kanpapa/VMEbus-AXPvme/README.md

# VMEbus-AXPvme
This repository contains documentation and sources for running DEC AXPvme 230
