kanpapa/VMEbus-AXPvme/KiCad/VME_axpvme230_p2/VME_axpvme230_p2_1.jpg

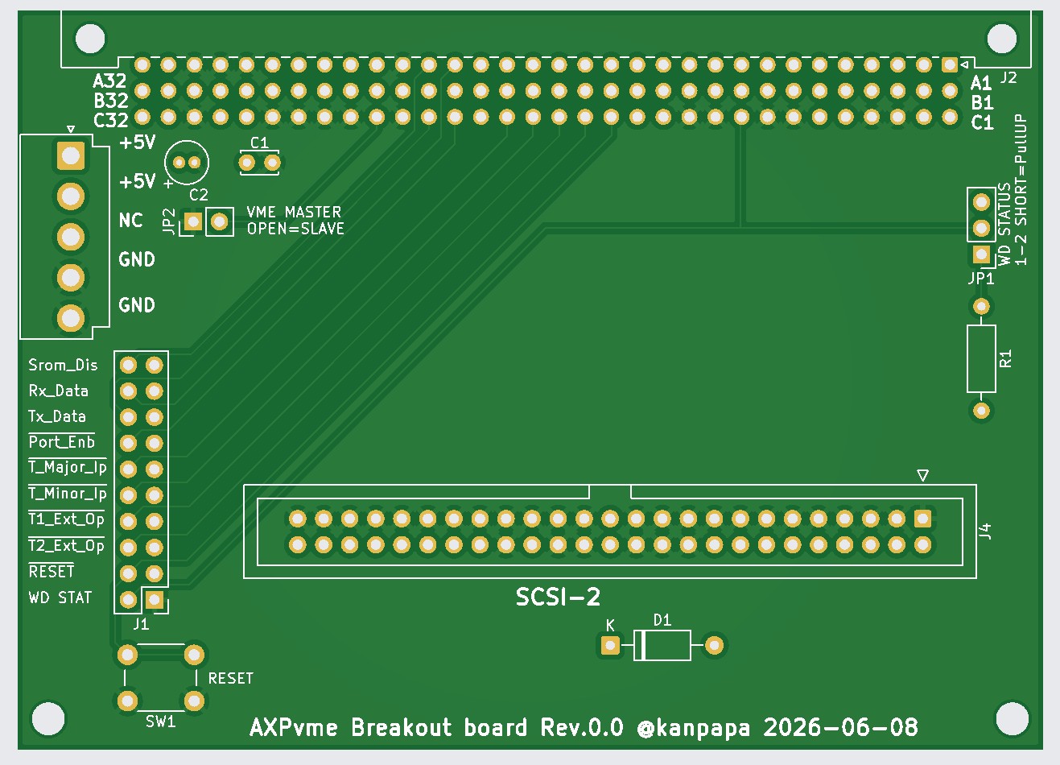
KiCad/VME_axpvme230_p2/VME_axpvme230_p2_1.jpg
