kanpapa/VMEbus-AXPvme/KiCad/VME_axpvme230_p2_dual/VME_axpvme230_p2_dual_sch.pdf

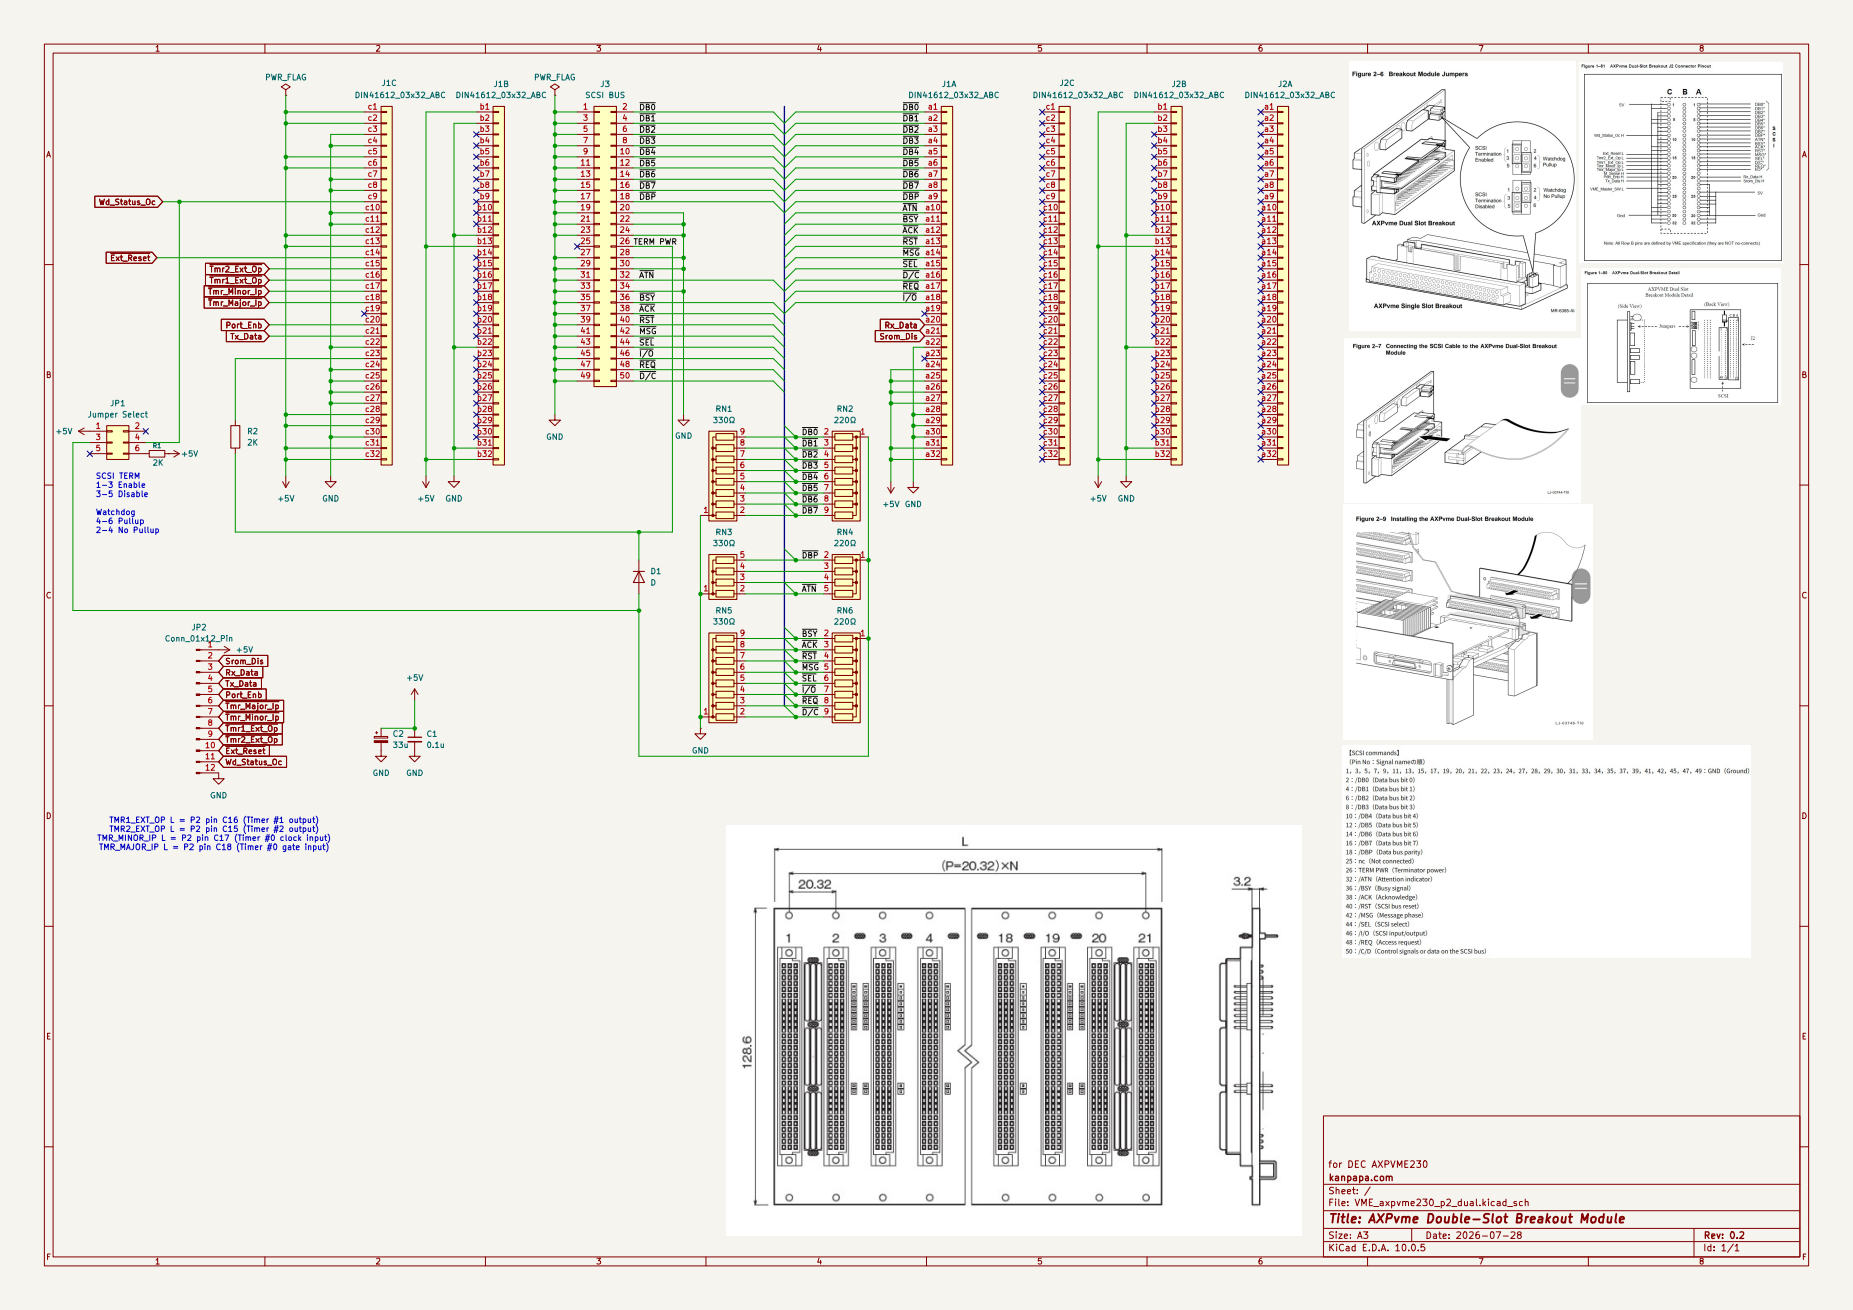
[picture p6: page 1]
