kanpapa/VMEbus-AXPvme/KiCad/VME_axpvme230_p2/VME_axpvme230_p2_sch.pdf

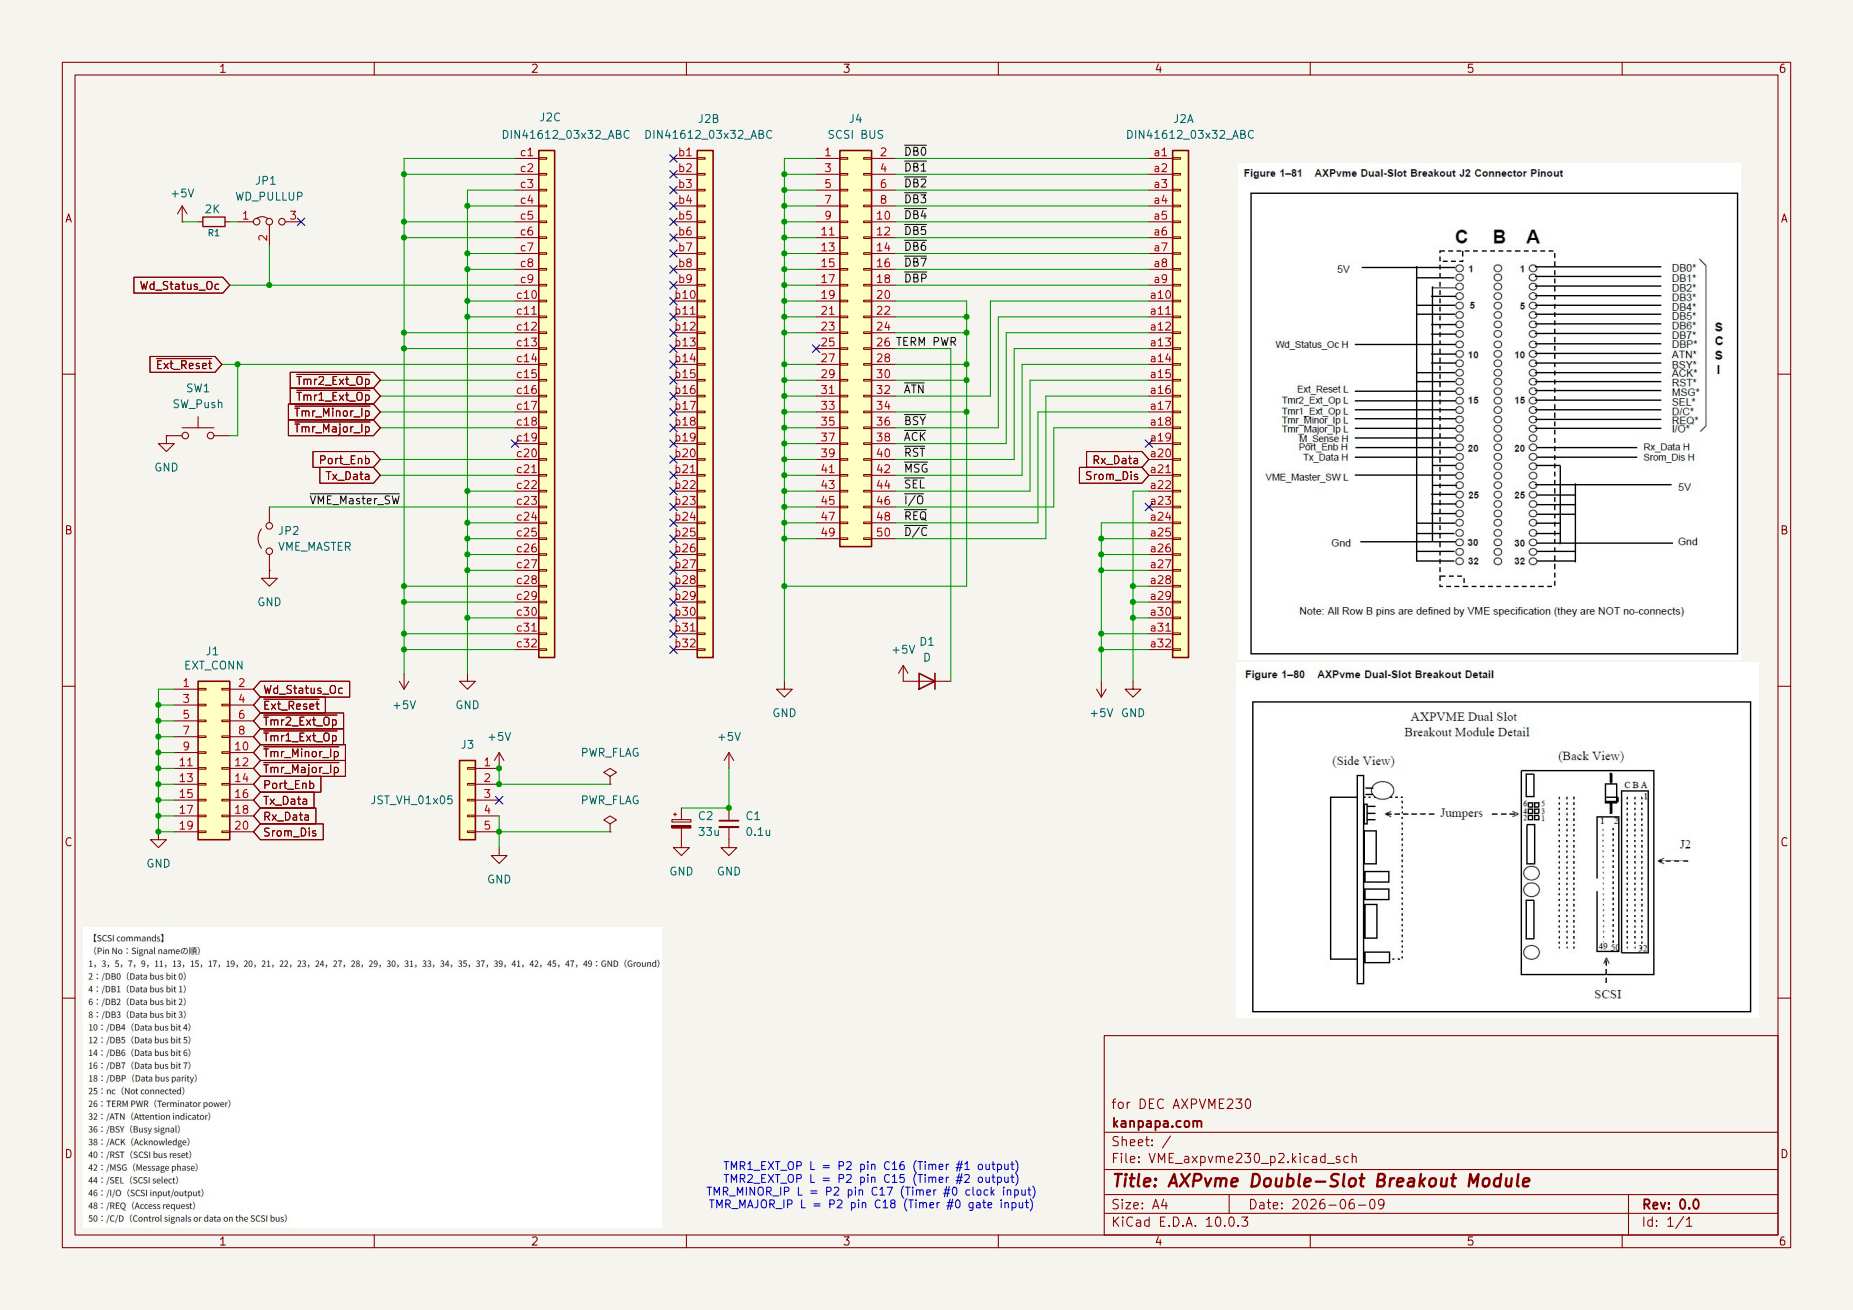
[picture p7: page 1]
