kanpapa/VMEbus-AXPvme/KiCad/VME_axpvme230_p2_dual/VME_axpvme230_p2_dual.kicad_pcb

## KiCad design KiCad/VME_axpvme230_p2_dual/VME_axpvme230_p2_dual.kicad_pcb (2026-07-12)

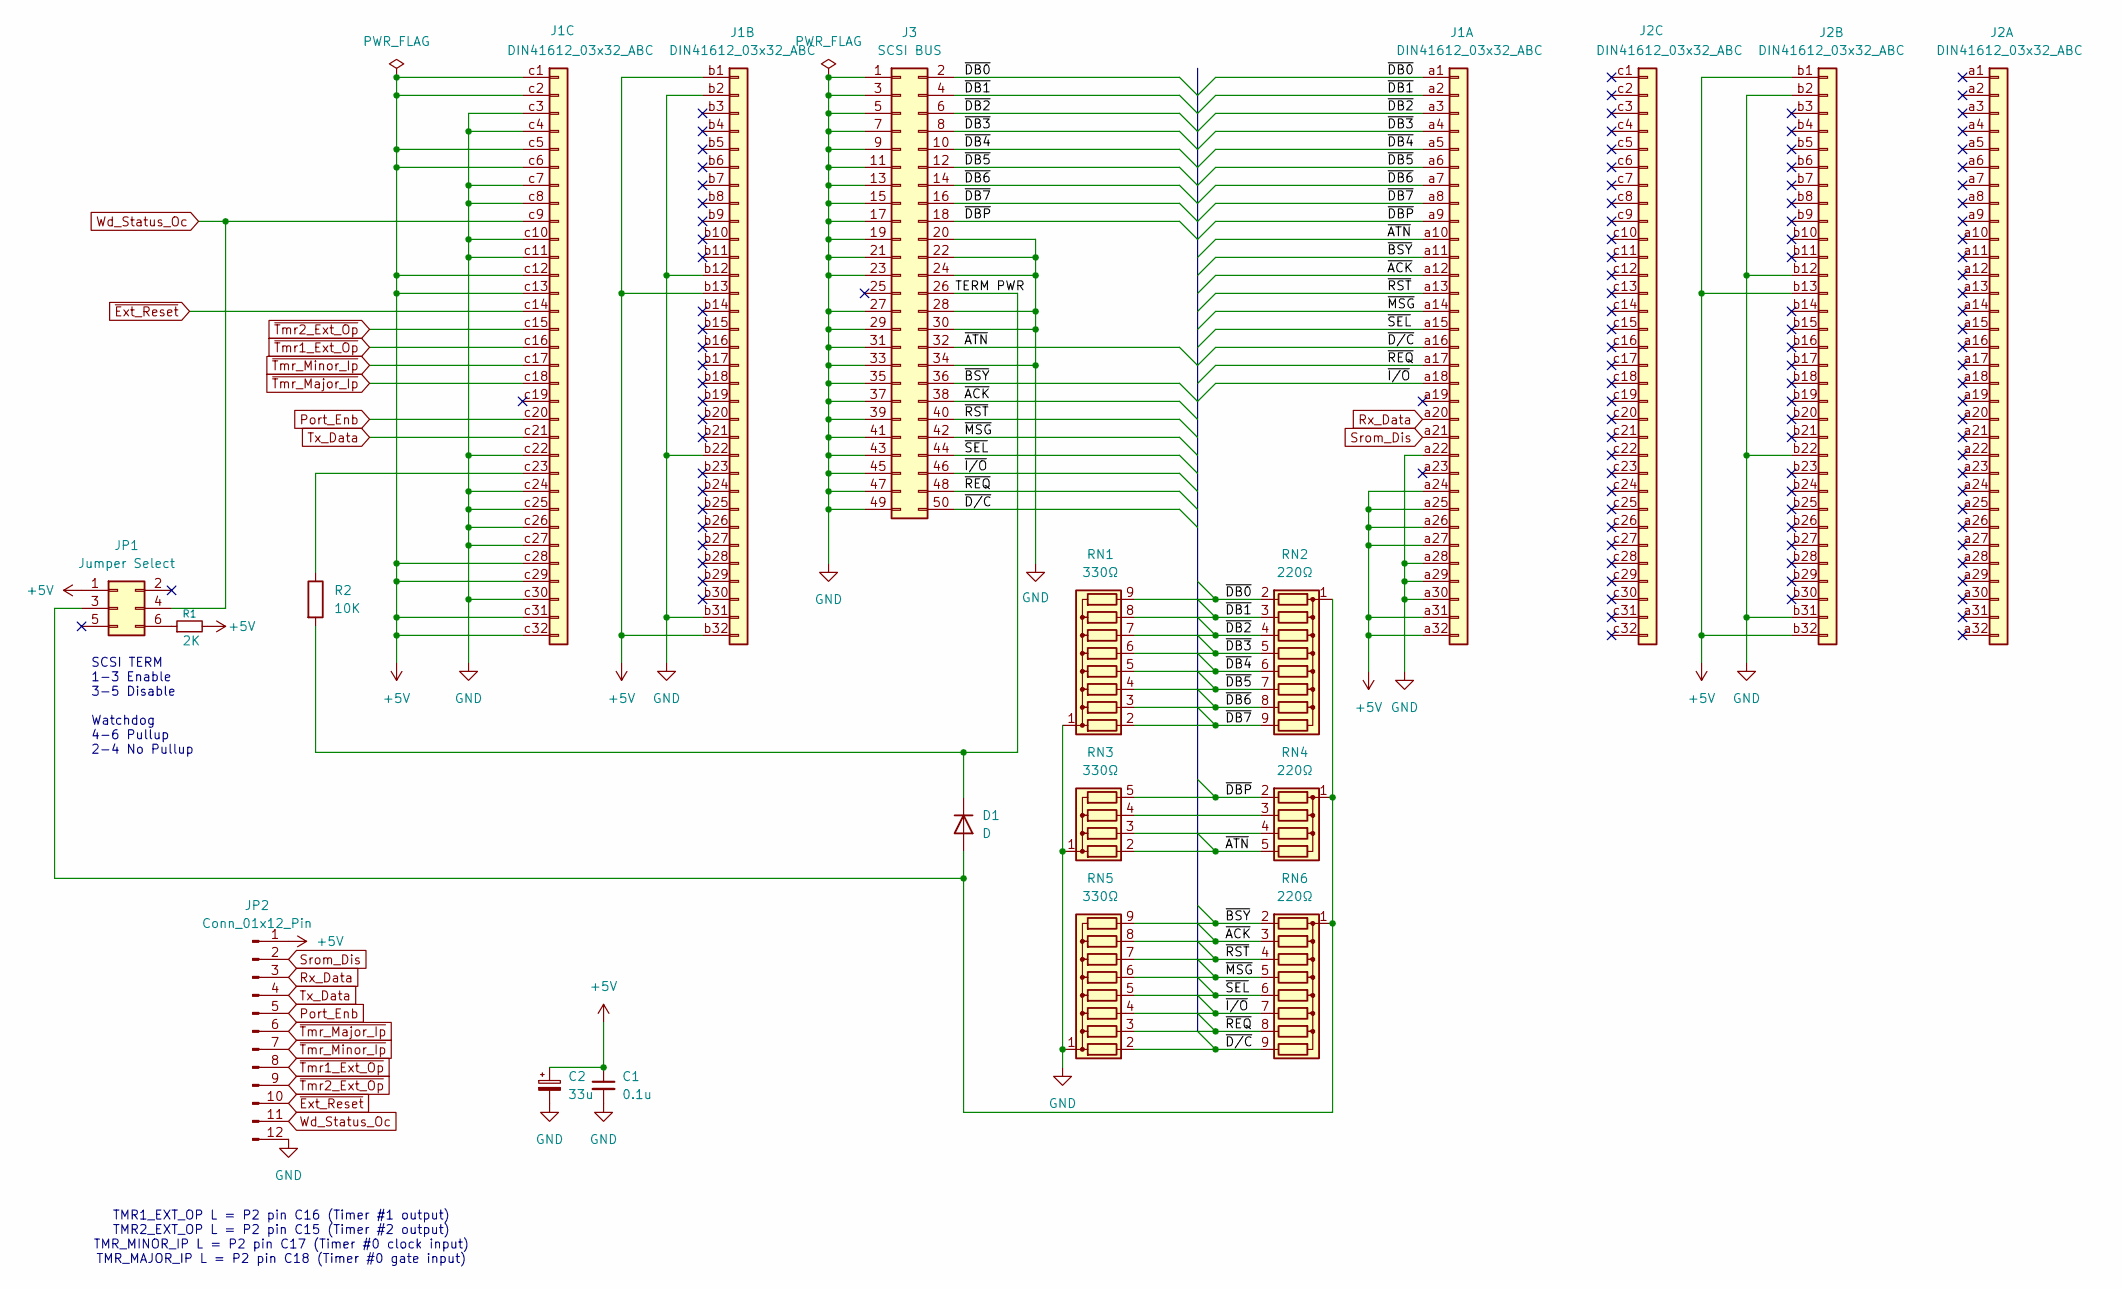
[picture p8: schematic VME_axpvme230_p2_dual.kicad_sch, AXPvme Double-Slot Breakout Module]

Parts:
C1: 0.1u; C_Disc_D3.4mm_W2.1mm_P2.50mm
C2: 33u; C_Radial_D4.0mm_H5.0mm_P1.50mm
D1: D; D_A-405_P7.62mm_Horizontal
J1, J2: DIN41612_03x32_ABC; DIN41612_C_3x32_Female_Vertical_THT
J3: SCSI BUS; IDC-Header_2x25_P2.54mm_Vertical
JP1: Jumper Select; PinHeader_2x03_P2.54mm_Vertical
JP2: Conn_01x12_Pin; PinHeader_1x12_P2.54mm_Vertical
R1: 2K; R_Axial_DIN0207_L6.3mm_D2.5mm_P7.62mm_Horizontal
R2: 10K; R_Axial_DIN0207_L6.3mm_D2.5mm_P7.62mm_Horizontal
RN1, RN5: 330Ω; R_Array_SIP9
RN2, RN6: 220Ω; R_Array_SIP9
RN3: 330Ω; R_Array_SIP5
RN4: 220Ω; R_Array_SIP5

Connections:
+5V: C1.1, C2.1, J1.a24, J1.a25, J1.a26, J1.a27, J1.a31, J1.a32, J1.b1, J1.b13, J1.b32, J1.c1, J1.c2, J1.c5, J1.c6, J1.c12, J1.c13, J1.c28, J1.c29, J1.c31, J1.c32, J2.b1, J2.b13, J2.b32, JP1.1, JP2.1, R1.2
/TERM PWR: D1.1 (K), J3.26, R2.2
/~ACK: J1.a12, J3.38, RN5.8 (R7), RN6.3 (R2)
/~ATN: J1.a10, J3.32, RN3.2 (R1), RN4.5 (R4)
/~BSY: J1.a11, J3.36, RN5.9 (R8), RN6.2 (R1)
/~DB0: J1.a1, J3.2, RN1.9 (R8), RN2.2 (R1)
/~DB1: J1.a2, J3.4, RN1.8 (R7), RN2.3 (R2)
/~DB2: J1.a3, J3.6, RN1.7 (R6), RN2.4 (R3)
/~DB3: J1.a4, J3.8, RN1.6 (R5), RN2.5 (R4)
/~DB4: J1.a5, J3.10, RN1.5 (R4), RN2.6 (R5)
/~DB5: J1.a6, J3.12, RN1.4 (R3), RN2.7 (R6)
/~DB6: J1.a7, J3.14, RN1.3 (R2), RN2.8 (R7)
/~DB7: J1.a8, J3.16, RN1.2 (R1), RN2.9 (R8)
/~DBP: J1.a9, J3.18, RN3.5 (R4), RN4.2 (R1)
/~D/C: J1.a16, J3.50, RN5.2 (R1), RN6.9 (R8)
/~I/O: J1.a18, J3.46, RN5.4 (R3), RN6.7 (R6)
/~MSG: J1.a14, J3.42, RN5.6 (R5), RN6.5 (R4)
/~REQ: J1.a17, J3.48, RN5.3 (R2), RN6.8 (R7)
/~RST: J1.a13, J3.40, RN5.7 (R6), RN6.4 (R3)
/~SEL: J1.a15, J3.44, RN5.5 (R4), RN6.6 (R5)
GND: C1.2, C2.2, J1.a22, J1.a28, J1.a29, J1.a30, J1.b2, J1.b12, J1.b22, J1.b31, J1.c3, J1.c4, J1.c7, J1.c8, J1.c10, J1.c11, J1.c22, J1.c24, J1.c25, J1.c26, J1.c27, J1.c30, J2.b2, J2.b12, J2.b22, J2.b31, J3.1, J3.3, J3.5, J3.7, J3.9, J3.11, J3.13, J3.15, J3.17, J3.19, J3.20, J3.21, J3.22, J3.23, J3.24, J3.27, J3.28, J3.29, J3.30, J3.31, J3.33, J3.34, J3.35, J3.37, J3.39, J3.41, J3.43, J3.45, J3.47, J3.49, JP2.12, RN1.1 (common), RN3.1 (common), RN5.1 (common)
unnamed: D1.2 (A), JP1.3, RN2.1 (common), RN4.1 (common), RN6.1 (common)
unnamed: J1.c23, R2.1
unnamed: JP1.6, R1.1
unnamed: RN3.3 (R2), RN4.4 (R3)
unnamed: RN3.4 (R3), RN4.3 (R2)
Port_Enb: J1.c20, JP2.5
Rx_Data: J1.a20, JP2.3
Srom_Dis: J1.a21, JP2.2
Tx_Data: J1.c21, JP2.4
Wd_Status_Oc: J1.c9, JP1.4, JP2.11
~Ext_Reset: J1.c14, JP2.10
~Tmr1_Ext_Op: J1.c16, JP2.8
~Tmr2_Ext_Op: J1.c15, JP2.9
~Tmr_Major_Ip: J1.c18, JP2.6
~Tmr_Minor_Ip: J1.c17, JP2.7

Notes on the sheet:
TMR1_EXT_OP L = P2 pin C16 (Timer #1 output) TMR2_EXT_OP L = P2 pin C15 (Timer #2 output) TMR_MINOR_IP L = P2 pin C17 (Timer #0 clock input) TMR_MAJOR_IP L = P2 pin C18 (Timer #0 gate input)
SCSI TERM 1-3 Enable 3-5 Disable Watchdog 4-6 Pullup 2-4 No Pullup

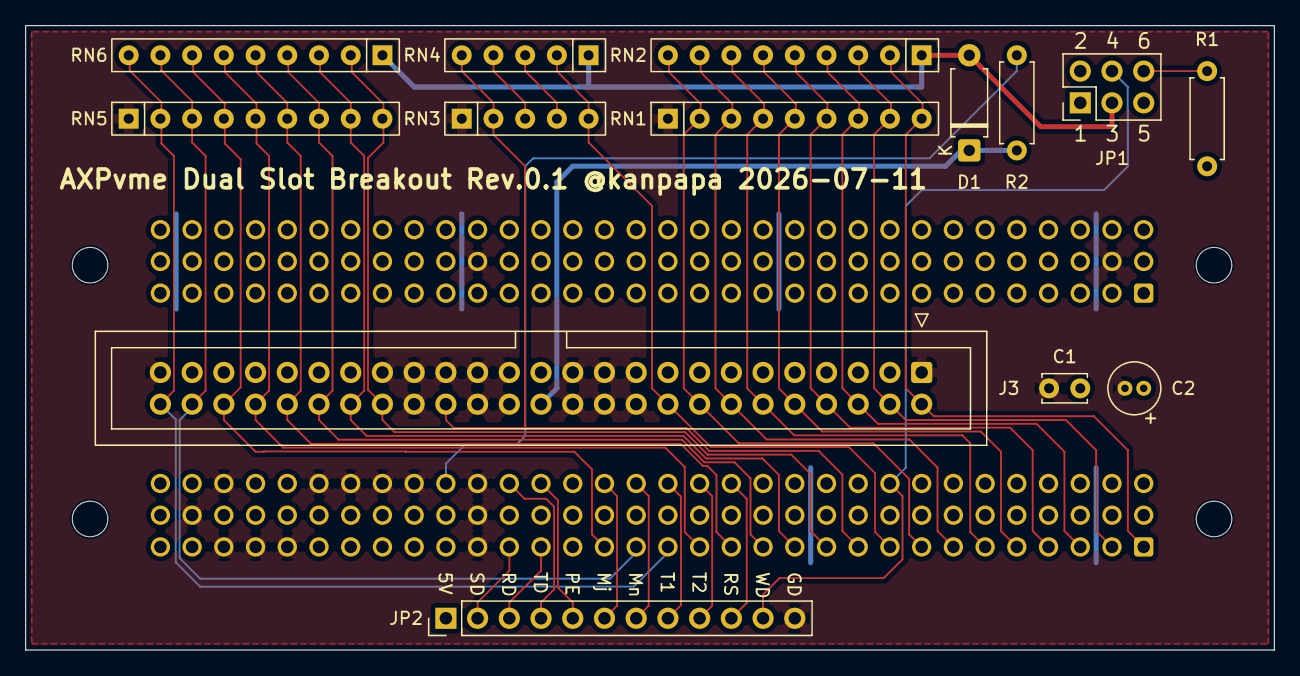
[picture p9: board VME_axpvme230_p2_dual.kicad_pcb from above]

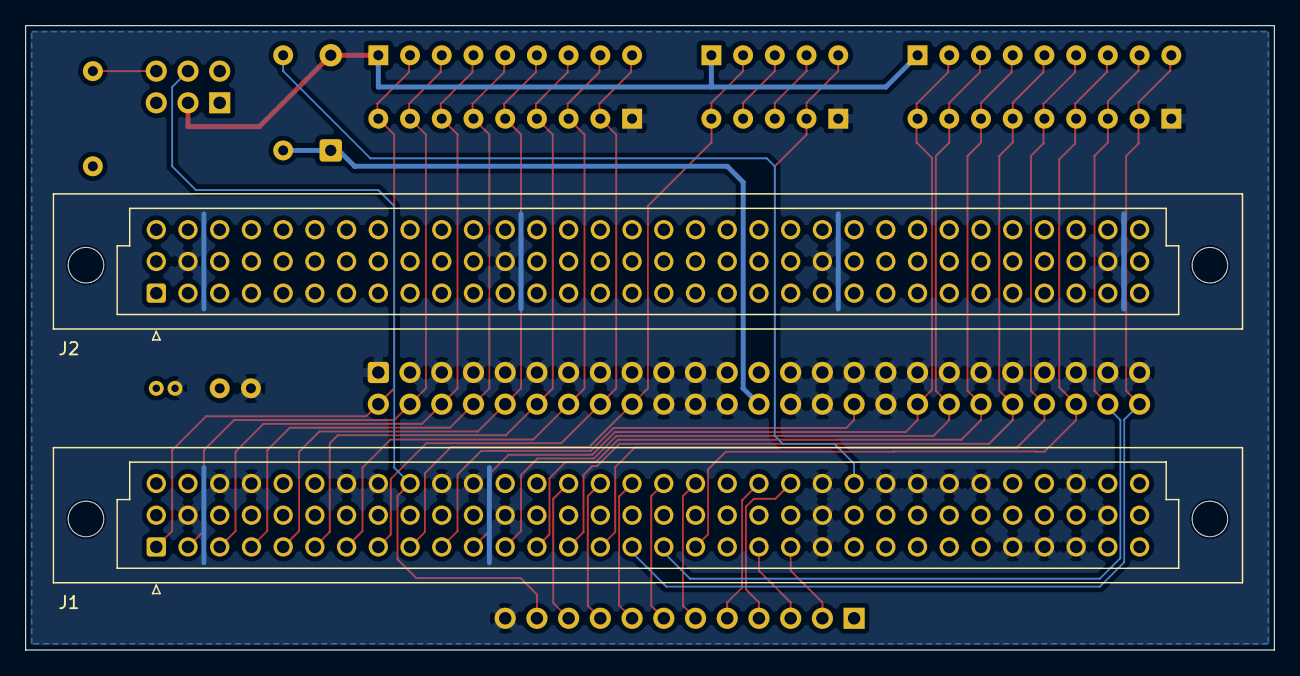
[picture p10: board VME_axpvme230_p2_dual.kicad_pcb from below]

Board: 4 copper layers, 100.0 x 50.0 mm, 16 parts (2 on the bottom side), 36 nets.
