kanpapa/VMEbus-AXPvme/KiCad/VME_axpvme230_p2/VME_axpvme230_p2.kicad_pcb

## KiCad design KiCad/VME_axpvme230_p2/VME_axpvme230_p2.kicad_pcb (2026-06-13)

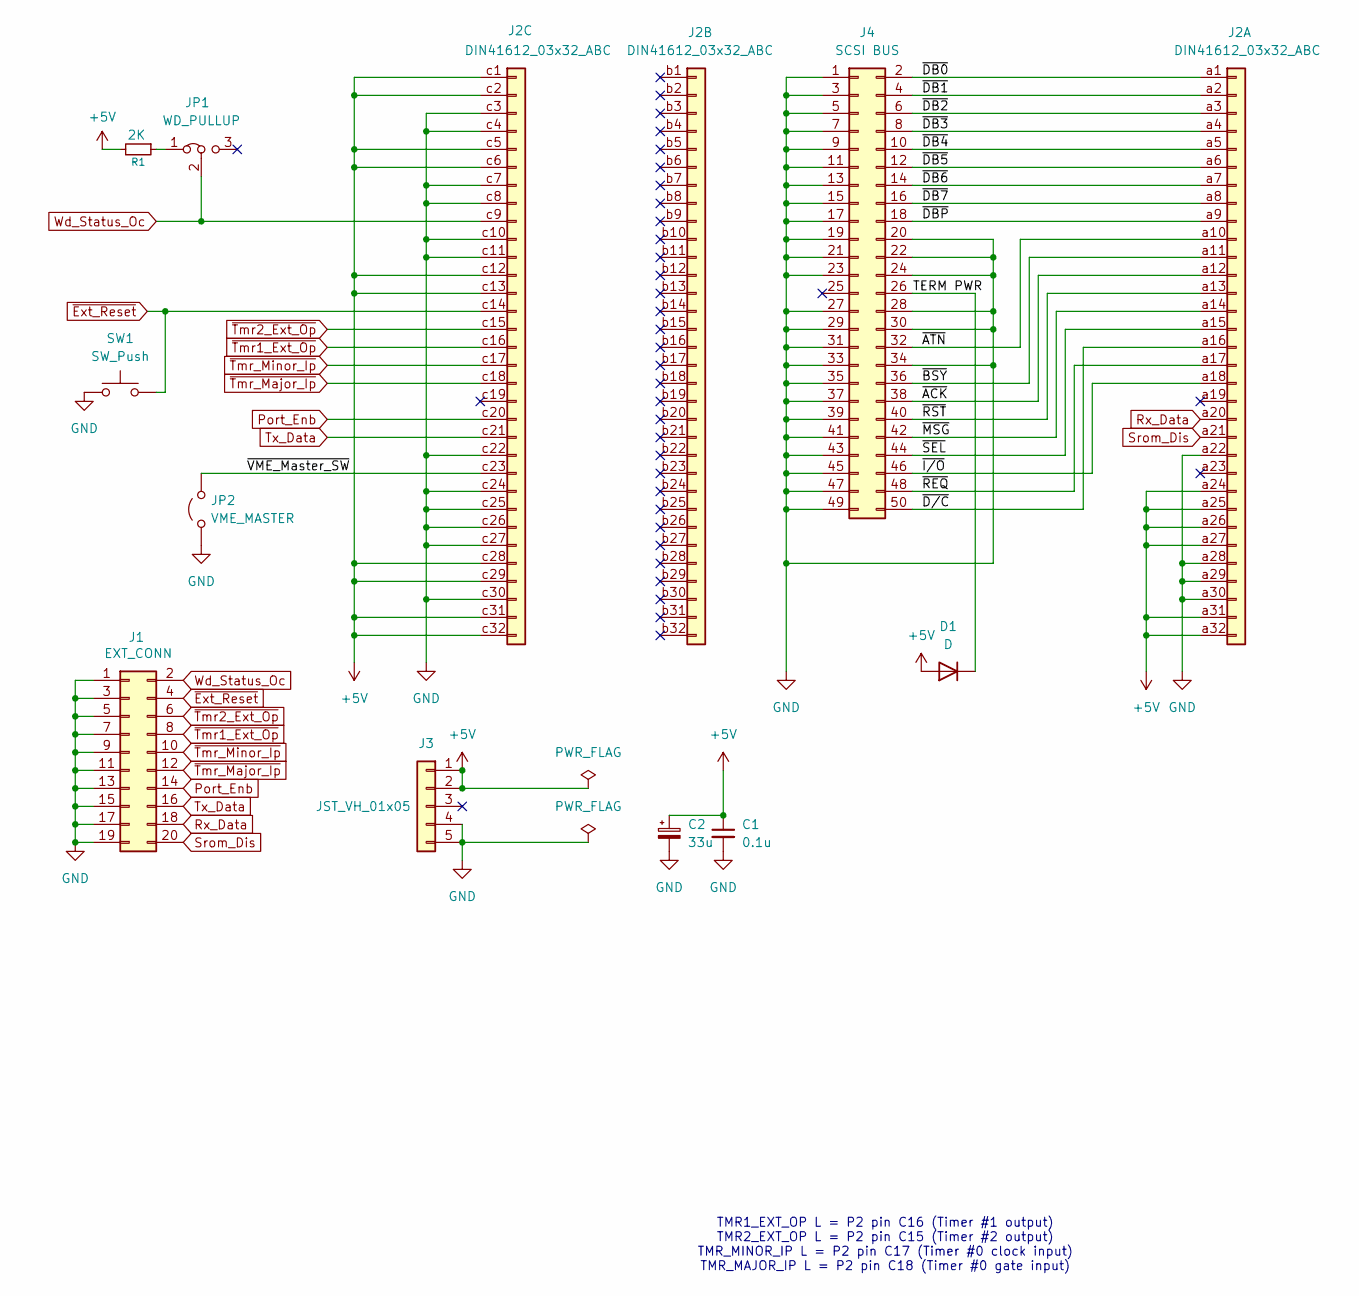
[picture p11: schematic VME_axpvme230_p2.kicad_sch, AXPvme Double-Slot Breakout Module]

Parts:
C1: 0.1u; C_Disc_D3.4mm_W2.1mm_P2.50mm
C2: 33u; C_Radial_D4.0mm_H5.0mm_P1.50mm
D1: D; D_A-405_P10.16mm_Horizontal
J1: EXT_CONN; PinHeader_2x10_P2.54mm_Vertical
J2: DIN41612_03x32_ABC; DIN41612_C_3x32_Male_Horizontal_THT
J3: JST_VH_01x05; JST_VH_B5P-VH_1x05_P3.96mm_Vertical
J4: SCSI BUS; IDC-Header_2x25_P2.54mm_Vertical
JP1: WD_PULLUP; PinHeader_1x03_P2.54mm_Vertical
JP2: VME_MASTER; PinHeader_1x02_P2.54mm_Vertical
R1: 2K; R_Axial_DIN0207_L6.3mm_D2.5mm_P10.16mm_Horizontal
SW1: SW_Push; SW_PUSH_6mm

Connections:
+5V: C1.1, C2.1, D1.2 (A), J2.a24, J2.a25, J2.a26, J2.a27, J2.a31, J2.a32, J2.c1, J2.c2, J2.c5, J2.c6, J2.c12, J2.c13, J2.c28, J2.c29, J2.c31, J2.c32, J3.1, J3.2, R1.2
/TERM PWR: D1.1 (K), J4.26
/~ACK: J2.a12, J4.38
/~ATN: J2.a10, J4.32
/~BSY: J2.a11, J4.36
/~DB0: J2.a1, J4.2
/~DB1: J2.a2, J4.4
/~DB2: J2.a3, J4.6
/~DB3: J2.a4, J4.8
/~DB4: J2.a5, J4.10
/~DB5: J2.a6, J4.12
/~DB6: J2.a7, J4.14
/~DB7: J2.a8, J4.16
/~DBP: J2.a9, J4.18
/~D/C: J2.a16, J4.50
/~I/O: J2.a18, J4.46
/~MSG: J2.a14, J4.42
/~REQ: J2.a17, J4.48
/~RST: J2.a13, J4.40
/~SEL: J2.a15, J4.44
/~VME_Master_SW: J2.c23, JP2.2 (B)
GND: C1.2, C2.2, J1.1, J1.3, J1.5, J1.7, J1.9, J1.11, J1.13, J1.15, J1.17, J1.19, J2.a22, J2.a28, J2.a29, J2.a30, J2.c3, J2.c4, J2.c7, J2.c8, J2.c10, J2.c11, J2.c22, J2.c24, J2.c25, J2.c26, J2.c27, J2.c30, J3.4, J3.5, J4.1, J4.3, J4.5, J4.7, J4.9, J4.11, J4.13, J4.15, J4.17, J4.19, J4.20, J4.21, J4.22, J4.23, J4.24, J4.27, J4.28, J4.29, J4.30, J4.31, J4.33, J4.34, J4.35, J4.37, J4.39, J4.41, J4.43, J4.45, J4.47, J4.49, JP2.1 (A), SW1.1
unnamed: JP1.1 (A), R1.1
Port_Enb: J1.14, J2.c20
Rx_Data: J1.18, J2.a20
Srom_Dis: J1.20, J2.a21
Tx_Data: J1.16, J2.c21
Wd_Status_Oc: J1.2, J2.c9, JP1.2 (C)
~Ext_Reset: J1.4, J2.c14, SW1.2
~Tmr1_Ext_Op: J1.8, J2.c16
~Tmr2_Ext_Op: J1.6, J2.c15
~Tmr_Major_Ip: J1.12, J2.c18
~Tmr_Minor_Ip: J1.10, J2.c17

Notes on the sheet:
TMR1_EXT_OP L = P2 pin C16 (Timer #1 output) TMR2_EXT_OP L = P2 pin C15 (Timer #2 output) TMR_MINOR_IP L = P2 pin C17 (Timer #0 clock input) TMR_MAJOR_IP L = P2 pin C18 (Timer #0 gate input)

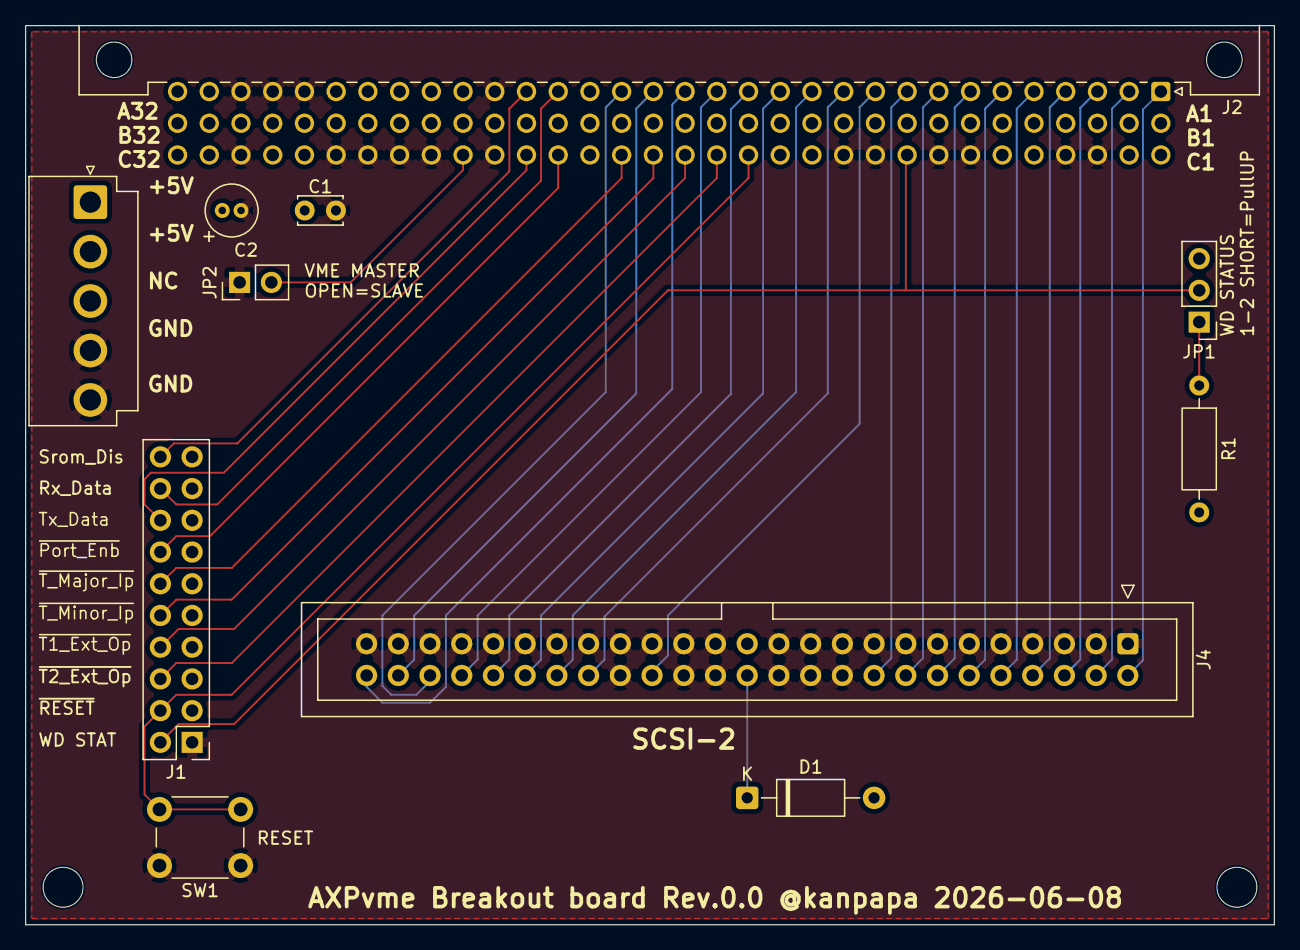
[picture p12: board VME_axpvme230_p2.kicad_pcb from above]

Board: 4 copper layers, 100.0 x 72.0 mm, 13 parts (0 on the bottom side), 33 nets.

Other parts of the board:
MH1, MH2: MountingHole_3.2mm_M3
