kanpapa/VMEbus-AXPvme/(commit log)

2026-06-13 1st commit
    [VME_axpvme230_p2.csv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]
2026-06-13 CSVのカラム修正
    [VME_axpvme230_p2.csv]
2026-06-13 BOMで品番違いを修正
    [VME_axpvme230_p2.csv]
2026-06-14 BOMの修正
    [VME_axpvme230_p2.csv]
2026-06-14 Breakout boardのREADMEを追加
2026-06-14 回路図を差し替え
2026-06-14 ハイフンが違うコードだったので修正
2026-06-16 Added led_test
2026-07-12 Added dual slot breakout
    [VME_axpvme230_p2_dual.csv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]
2026-07-12 pngをjpgに変更
2026-07-28 R2を2KΩに変更
    [VME_axpvme230_p2_dual.csv, VME_axpvme230_p2_dual.kicad_sch]
